marco402/piloteVMC/designSpark/README.md

# schéma  partie du projet PiloteVmc(// Développé par Marc Prieur (http://mesrealisations.000webhostapp.com/))

Les schémas sont développés sous DesignSpark pcb 8.1.
Je n'ai pas joint les pcb qui nécessiteront d'être repris en fonction des composants utilisés.

3 schémas sont présentés:
	-La partie traitement à base esp8266 et carte can bus.
	-La partie affichage à base arduino pro mini , carte can bus et afficheur st7735.
	-La partie relais pour boitier DIN.
	
	Le dossier user contient les composants ajoutés.
