marco402/piloteVMC/affichage/README.md

# Projet affichage partie du projet PiloteVmc(Développé par Marc Prieur https://marco40github.wixsite.com/website)

-Ce programme tourne sur un arduino mini pro.

-Il traite:
	-un poussoir sensitif pour changer de mode de fonctionnement(arrêt,vitesse lente,vitesse rapide...).
	-un afficheur ST7735.
	-le capteur humidité et température dht22 pour la cuisine.
	-le can bus liaison avec le boitier traitement.
	-un buzzer.
	-l'alimentation 5 volts est fournie par le boitier traitement par un câble de 4 fils bus can et alientation.
	-une prise à l'arrière du boitier permet de charger le programme par une liaison usb série.
