marco402/piloteVMC/traitement/README.md

------------------------------------------------------------------------------------------------------------------------

# Projet traitement partie du projet PiloteVmc(// Développé par Marc Prieur (https://marco40github.wixsite.com/website))

-Ce programme tourne sur un esp8266 0.9.

-Traitements:
 - Capteurs.
 - Liaison téléinformatique EDF.
 - CAN bus vers l'affichage réception des commandes.
 - Enregistrement.
 - Mise à l'heure
 - Commande de la VMC
