marco402/piloteVMC/TeleinfoVmc/README.md

Version initiale de TeleInfo
    version  https://github.com/BmdOnline/Teleinfo du 22/02/2017

Evolutions d'une version spécifique développée par Marc Prieur 07/2019.

Différences majeur avec la version initiale de TeleInfo:
    -La base de donnée est spécifique à l'application PiloteTempoVmc.
    -La librairie graphique est limitée à Highchart/HighStock.
    -Je n'ai pas repris/testé la version mobile.
    -J'ai intégré/testé que la version teleinfo mode historique.
    -J'ai ajouté la possiblité en cliquant sur la courbe d'enregistrer dans la base et d'afficher des annotations.
    -Ajout de 2 courbes spécifiques vmc et fonctionnel.

Pour davantage d'information, voir INSTALL.MD et https://mesrealisations.000webhostapp.com/.
