marco402/piloteVMC/sql/README.md

# Projet sql partie du projet PiloteVmc(// Développé par Marc Prieur (http://mesrealisations.000webhostapp.com/))

-Installer et paramétrer wamp server.

-Ouvrir phpmyadmin à partir de l'icone de wamp.

-Créer l'utilisateur (piloteVmc).
	-Privilèges --->ajouter nouvel utilisateur.
	-Mot de passe et privilèges...
	-Exécuter.

-Se positionner sur  le nouvel utilisateur .
	-Importer
	-Sélectionner le fichier du dossier sql.
	-Exécuter.

https://mesrealisations.000webhostapp.com/?p=569
