marco402/piloteVMC/todo.md

# Matériel
- Alimentation problème de reset notemment au déclenchement des radiateurs électriques(actuellement bloc externe simple).
- Revoir le capteur de courant entrée A0 hs, le capteur  au niveau du compteur doit capter trop de parasite destructeurs.
- Réglage luminositée de l'afficheur.
- Ajout d'une carte mini SD pour l'enregistrement limité actuellement à 1 jour avec un dt de 5mn.

# Logiciel
- Sur changement de mode simultané de auto vers arrêt avec un changement automatique marche arrêt simultané,
			la ventilation est passée en grande vitesse avec arrêt affiché.
