marco402/piloteVMC/designSpark/affichage_V2_st7735/affichage_v2.pdf

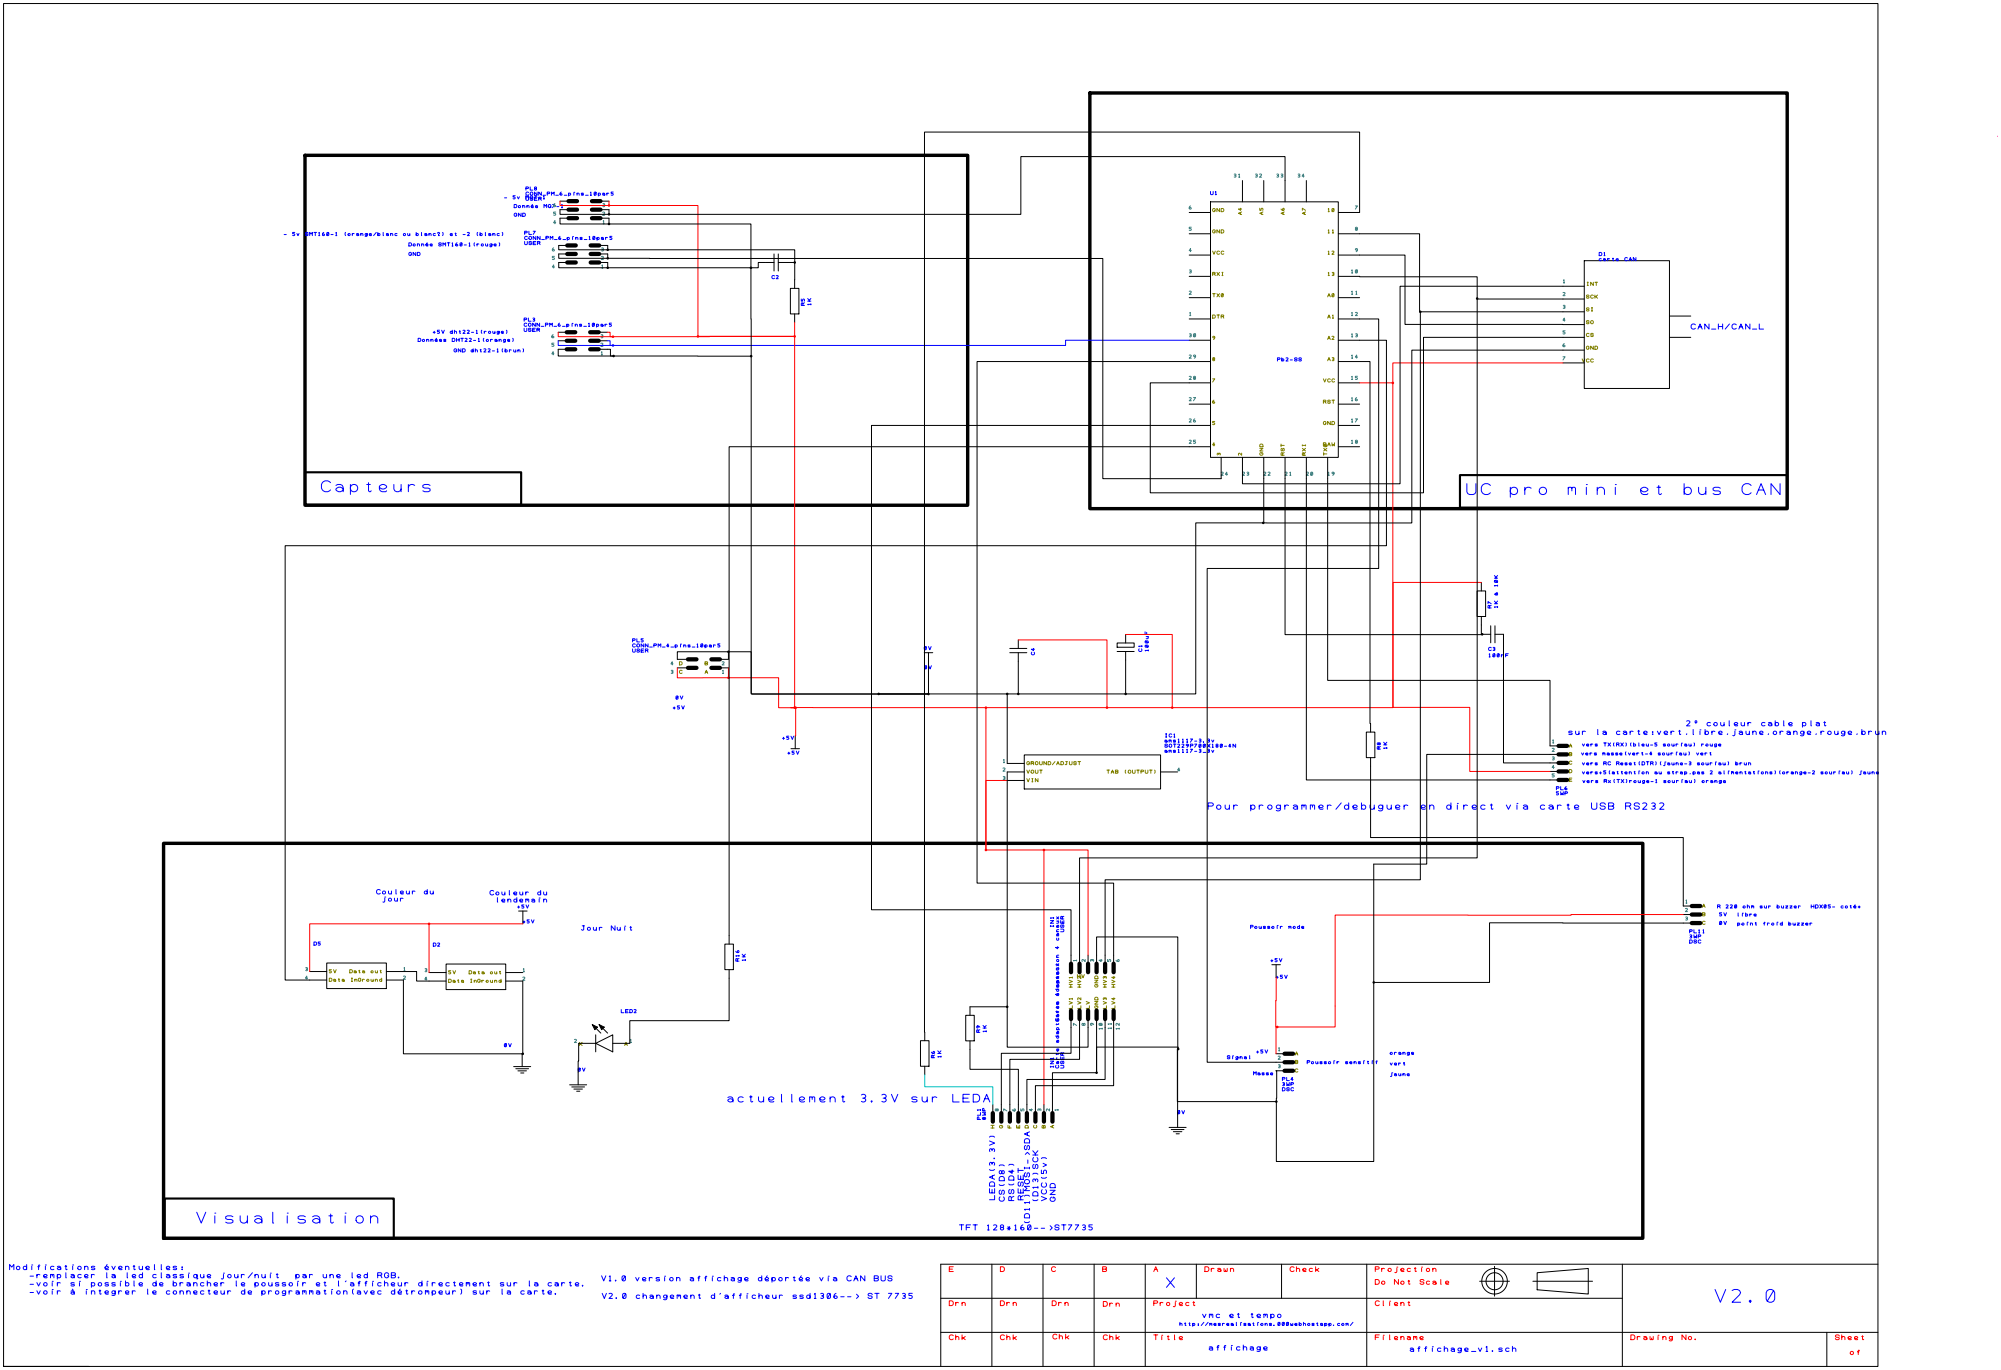
[picture p1: page 1]
