marco402/piloteVMC/designSpark/carte_relais_V2/relais.pdf

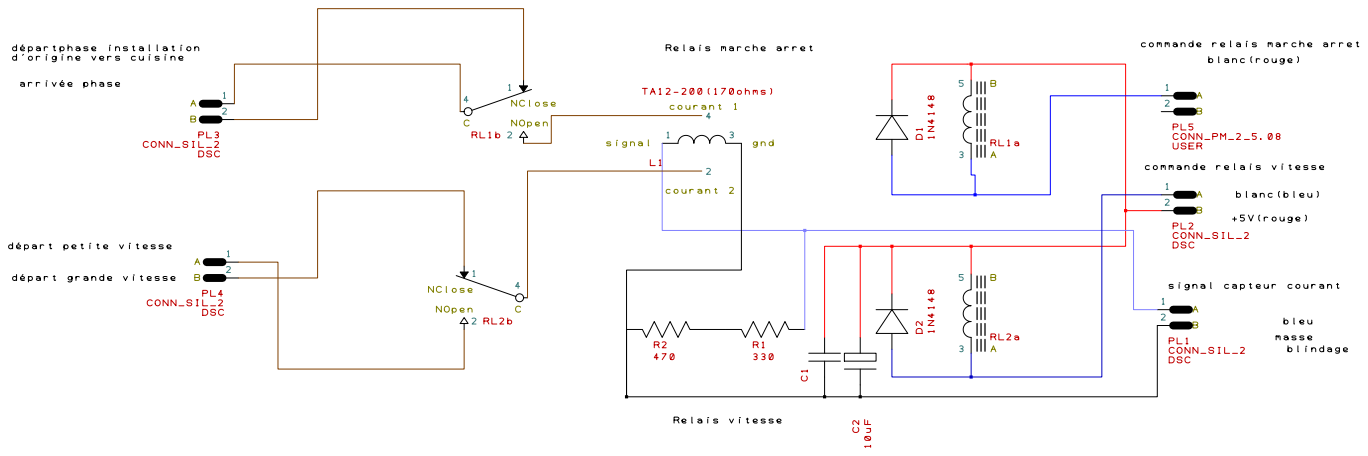
[picture p2: page 1]
