marco402/piloteVMC/designSpark/traitement/Traitement.pdf

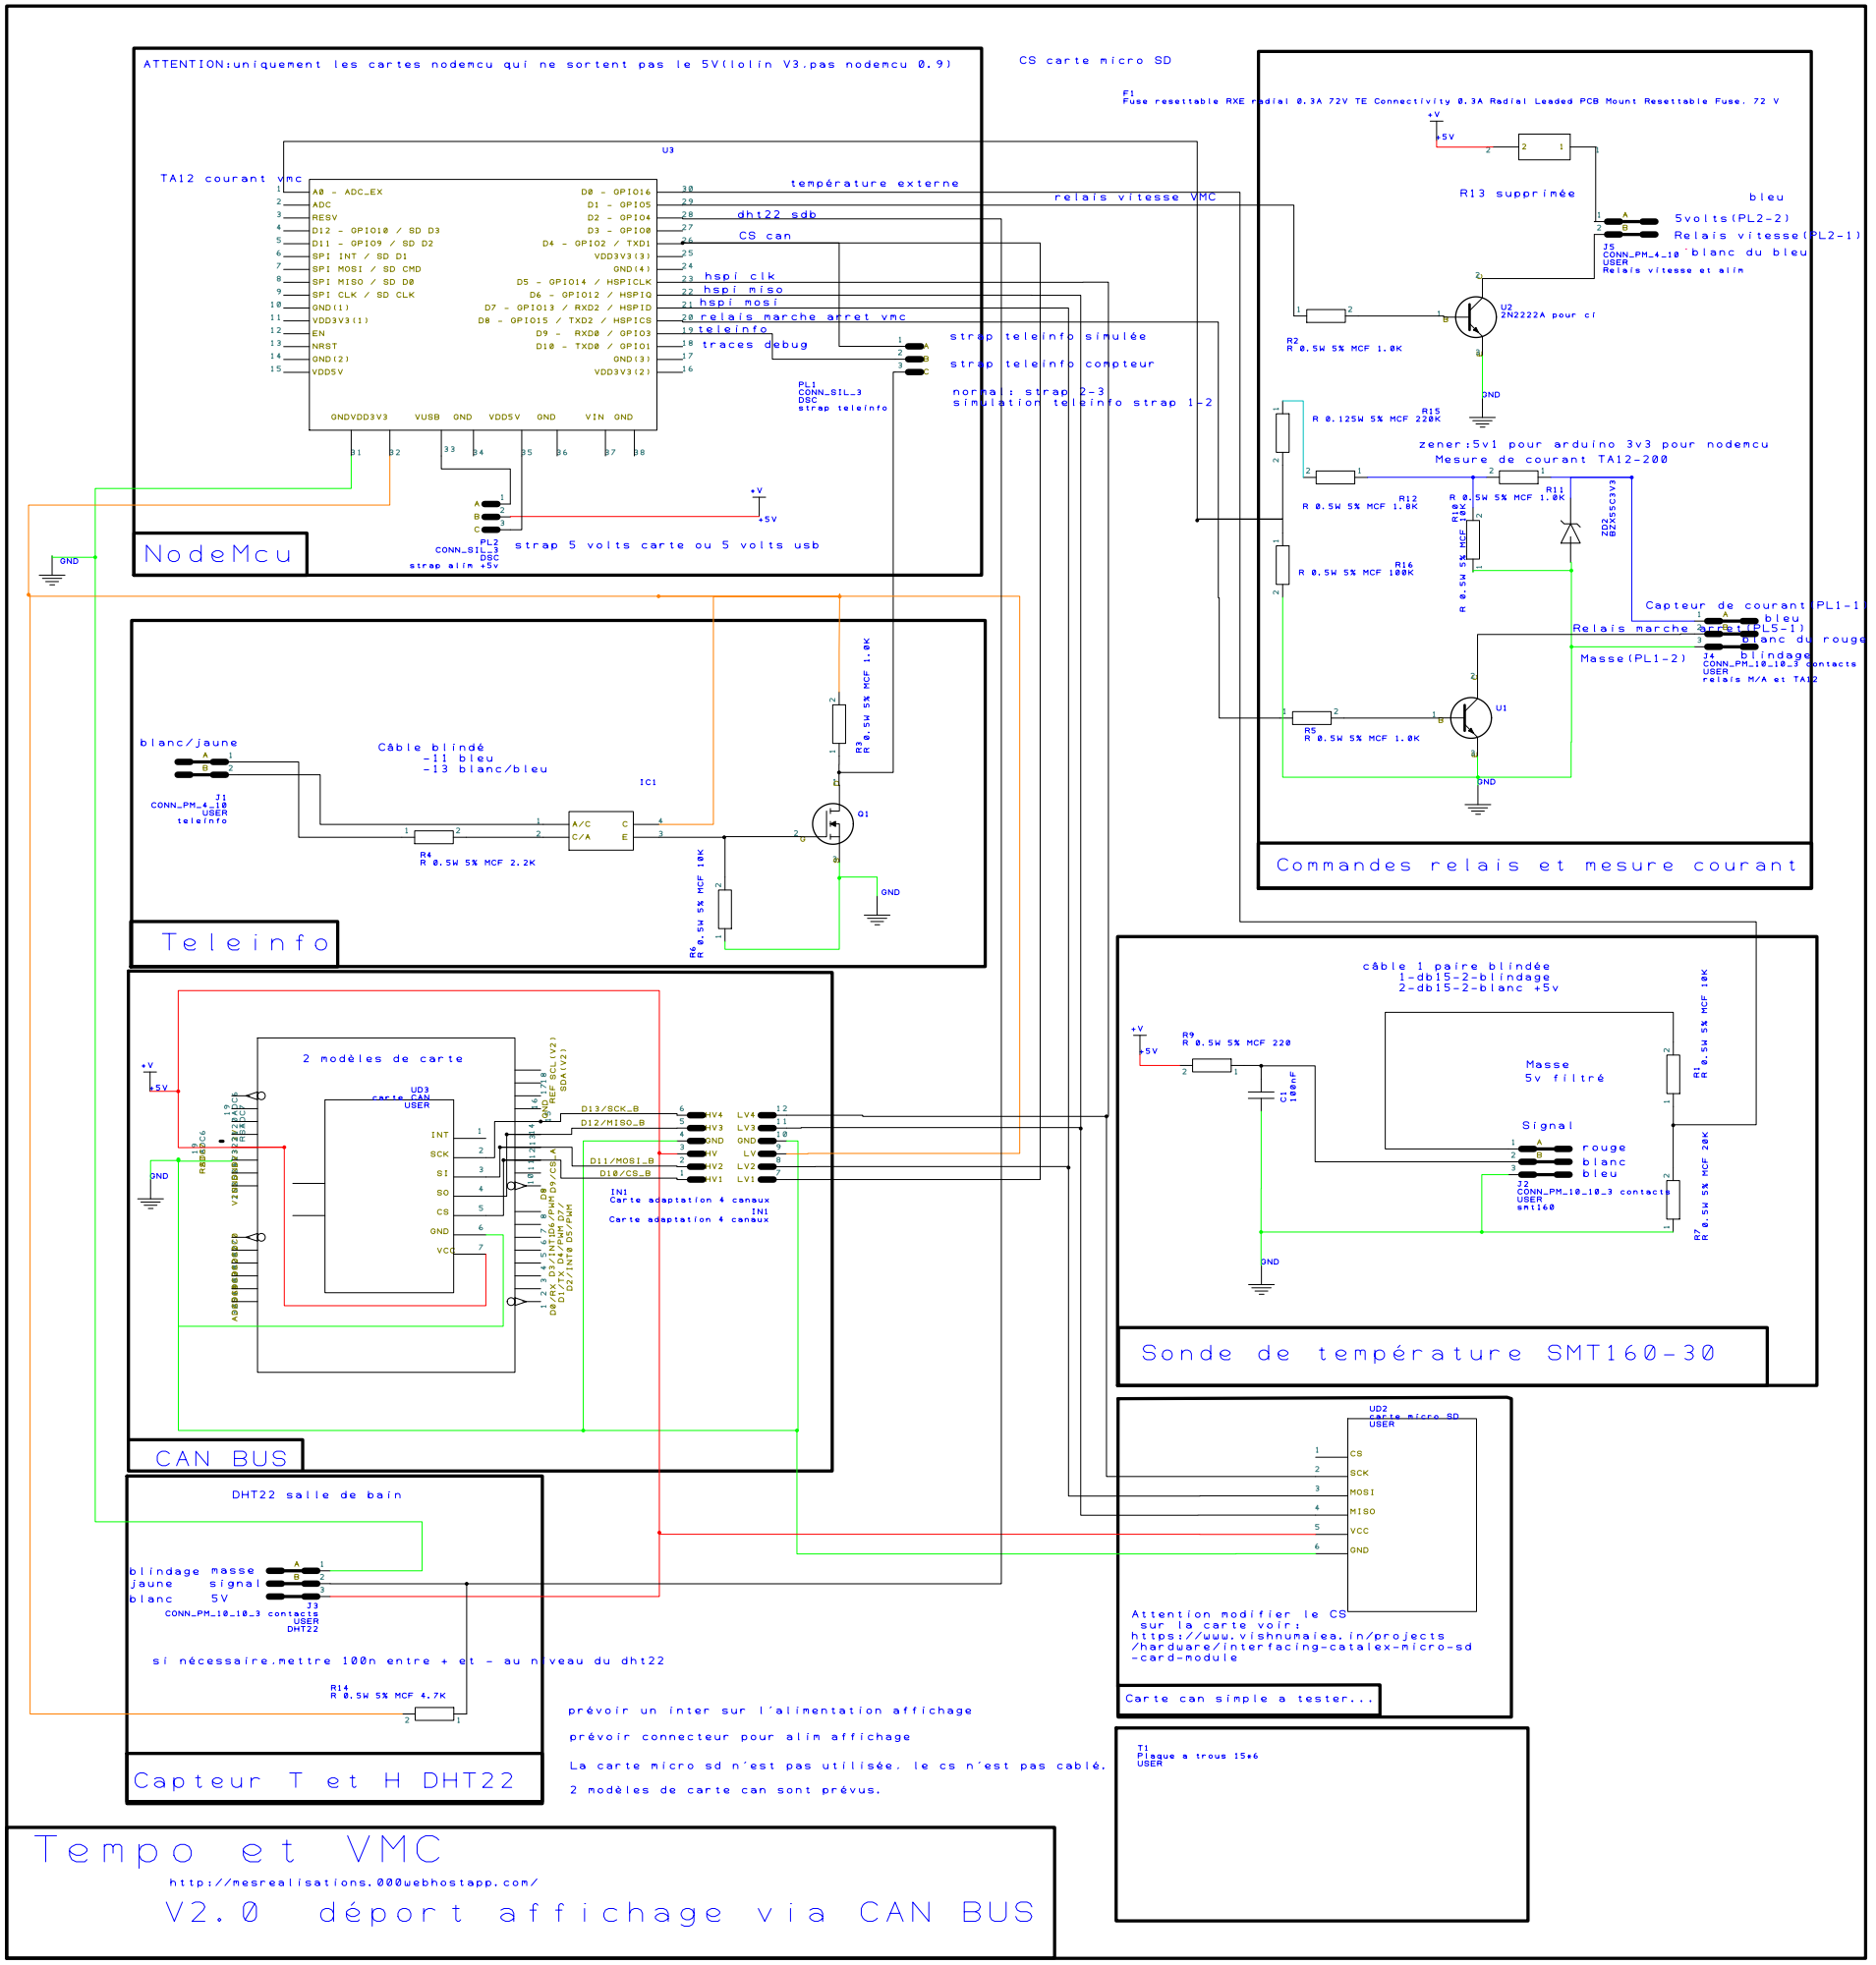
[picture p3: page 1]
