marco402/piloteVMC/LTspice/TA12 - 3.asc

C1: cap; 10n
D1: diode
D2: diode
R1: res; 100k
R2: res; 330k
R3: res; 800
V1: voltage; SINE(0 0.1 50); Rser=800
V2: voltage; 3.3
Named nets: 0, A0
.model BZX55C3V3 D(Is=1.5n Rs=.5 Cjo=185p nbv=3 bv=3.3 Ibv=1m Vpk=3.3 mfg=OnSemi type=Zener)
;ac lin 100 50 50
.tran 0.1
