marco402/piloteVMC/LTspice/TA12 - ok.asc

C1: cap; 10µ
R1: res; 150k
R2: res; 100k
R3: res; 800
R4: res; 220k
R5: res; 100k
V1: voltage; SINE(0 0.27 50); Rser=800
V2: voltage; 3.3
Named nets: 0, A0
.tran 0.1
https://openenergymonitor.org/forum-archive/node/156.html
