marco402/piloteVMC/LTspice/TA12.asc

D1: diode
D2: diode
DZ1: zener; BZX55C3V3
R1: res; 330
R2: res; 470
R3: res; 10000
R4: res; 220000
R5: res; 100000
R6: res; 1000
V1: voltage; SINE(0 0.270 50); Rser=800
Named nets: 0, A0
.model BZX55C3V3 D(Is=1.5n Rs=.5 Cjo=185p nbv=3 bv=3.3 Ibv=1m Vpk=3.3 mfg=OnSemi type=Zener)
;ac lin 100 50 50
.tran 0.1
