marco402/piloteVMC/traitement/vmc.cpp

// **********************************************************************************
// Programme traitement ESP8266 Pilotage VMC et TEMPO->Traitement de la VMC
// **********************************************************************************
// Creative Commons Attrib Share-Alike License
// You are free to use/extend this library but please abide with the CC-BY-SA license:
// Attribution-NonCommercial-ShareAlike 4.0 International License
// http://creativecommons.org/licenses/by-nc-sa/4.0/
//
// Written by Marc Prieur (https://marco40github.wixsite.com/website))
//
// History : V1.00 2018-03-23 - First release
//				   2021 ajout mode ETE HIVER
//
// All text above must be included in any redistribution.
//
// **********************************************************************************
//06/2022  supression des heures pour le mode été
//***********************************************************************************
#include <pgmspace.h>
#include <Arduino.h>
#include "Wifinfo.h"
#include "mySyslog.h"
#include "mySntp.h"
#include "constantes.h"
#include "dht.h"
#include "smt160.h"
#ifdef TA12
	#include "ta12.h"
#endif
#ifdef ALARME
#include "alarme.h"
#endif
#include "buzzer.h"
#include "config.h"
#include "interRelais.h"
#include "mySntp.h"
#include <WiFiUdp.h>  //pour enregistrement
#include "enregistrement.h"
#include "canBus.h"
#include "vmc.h"
#include "LibTeleinfo.h"
vmc::vmc()
{
}
void vmc::TRAITEMENTVMC(void)
{
	//***************************************Gestion de la mise en marche du relais de démarrage*************************************
	RELAIS.tempoChangementEtatRelais();
	//**************************************Traitement du mode VMC****************************************************
	//*****************Si le mode a changer, initialisation du nouveau mode
	//ATTENTION,le mode change ici mais le relais marche arret sera commandé 5 secondes plus tard-->en attendant:etatRelaisMarcheArret=ArretMarche::ARRET_REL;
	initialisationMode();
	lectureCapteurs();
	traitePeriodeVmc();
}

//void vmc::testTraitementVmc(void)
//{
////#ifndef TRAITMODE
//	if (traiteArretMarcheForce() == 0)
//	{
//			traitePeriodeVmc();
//	}
////#else
////			traitePeriodeVmc();
////#endif
//}

//appelé cycliquement sans condition par main_pilote_vmc.cpp
void vmc::setCptVmc(uint16_t T)
{
	cptSecondesVmcAuto = T;
}
void vmc::traiteRazCapteursAuto(void)
{
	if (cptSecondesVmcAuto >= (uint16_t)CONFIGURATION.config.tempo.periode_vmc_sec)  //déplacé ici sinon capteur de courant a 0
	{
		traiteMoyennePeriode();
		if (!(leMode == MODES::AUTO || leMode == MODES::ETE || leMode == MODES::HIVER))   //pour continuer a traiter les moyennes a la cadence vmc
			cptSecondesVmcAuto = 0;
	}
}
//void vmc::traiteEte()
//{
//	//DebugF("TEMPEXT: ");	Debugln((long)TEMPEXT.getMoyennePeriode());
//	//DebugF("DHTSDB.DHT_T: ");	Debugln((long)DHTSDB.DHT_T.getMoyennePeriode());
//	boolean entreAirFrais = (TEMPEXT.getMoyennePeriode() < (DHTSDB.DHT_T.getMoyennePeriode()));
//	//DebugF("entreAirFrais: ");	Debugln((long)entreAirFrais);
//	if (entreAirFrais)
//    {
//		RELAIS.traitementRelais(VITESSE_RELAIS::LENT_REL, ARRET_MARCHE::MARCHE_REL);
//    }
//	else
//    {
//		leMode = MODES::AUTO;
//		memoModes = MODES::AUTO;
//		decompteTempoArretMarcheForce = 0;
//		//RELAIS.traitementRelais(VITESSE_RELAIS::LENT_REL, ARRET_MARCHE::ARRET_REL);
//    }
//}
void vmc::traitementVMCHiver()
{
	//DebugF("TEMPEXT: ");	Debugln((long)TEMPEXT.getMoyennePeriode());
	//DebugF("TEMPSDB: ");	Debugln((long)DHTSDB.DHT_T.getMoyennePeriode());
//	if ((TEMPEXT.getMoyennePeriode() > (DHTSDB.DHT_T.getMoyennePeriode())))
	//if (RELAIS.getJour_Nuit())		//0:jour,3:nuit
	if(Clock.getHour() > 5 && Clock.getHour() < 23)
	{
		//DebugF("BIDON ");
		//forcageMode = MODES::BIDON;
		RELAIS.traitementRelais(VITESSE_RELAIS::LENT_REL, ARRET_MARCHE::ARRET_REL);
		//RELAIS.traitementRelais(VITESSE_RELAIS::LENT_REL, ARRET_MARCHE::MARCHE_REL);
	}
	else
	{
		traitementVMC();
		cptSecondesVmcAuto = 0;
		//DebugF("AUTO ");
		//forcageMode = MODES::AUTO;
		//leMode = MODES::AUTO;  //il faudrait indiquer a affichage->poussoir de forcer le mode auto
		//memoModes = MODES::AUTO;
//#ifndef TRAITMODE
		//decompteTempoArretMarcheForce = 0;
//#endif
	}
		//RELAIS.traitementRelais(VITESSE_RELAIS::LENT_REL, ARRET_MARCHE::ARRET_REL);
}

void vmc::traitePeriodeVmc()
{
	//if (traiteArretMarcheForce() > 0)
	//	return;
	if (cptSecondesVmcAuto >= (uint16_t)CONFIGURATION.config.tempo.periode_vmc_sec)
	{
		if (leMode == MODES::AUTO)
		{
			traitementVMC();
			cptSecondesVmcAuto = 0;
		}
		else if (leMode == MODES::ETE)
		{
			traitementVMCEte();
			cptSecondesVmcAuto = 0;
		}
		else if (leMode == MODES::HIVER)
		{
			traitementVMCHiver();
			cptSecondesVmcAuto = 0;
		}
		else
		{
			casAuto = 0;	//effacement du status auto
			info = CASSTATUS::ST_START;
#ifdef TA12
			TA12.traitementSeuilTa12();	//true si ok
#endif
		}
	}
	//if (leMode == MODES::ETE)
	//{
	//	traitementVMC();
	//	cptSecondesVmcAuto = 0;
	//	//traiteEte();
	//}
	//else 
	//if (leMode == MODES::HIVER)
	//{
	//	traitementVMCHiver();
	//	cptSecondesVmcAuto = 0;
	//}
}
void vmc::incrementeCptVmc()
{
	cptSecondesVmcAuto++;
}
//appel que si on a changé de mode Marche/arret, petite/grande vitesse ou automatique...
void vmc::initialisationMode()
{
	//DebugF("decompteTempoArretMarcheForce:"); Debugln(decompteTempoArretMarcheForce);
	//DebugF("tempoFinForcage:"); Debugln(tempoFinForcage);
	//noInterrupts();	//au cas ou: framework arduino ???
	if (memoModes != leMode)
	{
//#ifndef TRAITMODE
		memoRetourForcage = memoModes;
		decompteTempoArretMarcheForce = 0;				//sinon repart en auto en fin de tempo si on a pas fini le forçage
//#endif
		switch (leMode)
		{
		case MODES::ARRET:
			RELAIS.traitementRelais(VITESSE_RELAIS::LENT_REL, ARRET_MARCHE::ARRET_REL);
			ENREGISTREMENT.setCptSecPeriodeEnregistrement();		//pour les modes arret, les modes marche sont après la tempo sinon erreur sur marche/arret
      MYALARMEGARAGE.setRazAlarme();
       MYALARMEPORTAIL.setRazAlarme();
			break;
		case MODES::PETITE_VITESSE:
			RELAIS.traitementRelais(VITESSE_RELAIS::LENT_REL, ARRET_MARCHE::MARCHE_REL);
			break;
		case MODES::GRANDE_VITESSE:
			RELAIS.traitementRelais(VITESSE_RELAIS::RAPIDE_REL, ARRET_MARCHE::MARCHE_REL);
			break;
		case MODES::TEMPO_ARRET:
			RELAIS.traitementRelais(VITESSE_RELAIS::LENT_REL, ARRET_MARCHE::ARRET_REL);
			ENREGISTREMENT.setCptSecPeriodeEnregistrement();		//pour les modes arret
//#ifndef TRAITMODE
			//decompteTempoArretMarcheForce = CONFIGURATION.config.tempo.duree_forcage_sec;
//#endif
			break;
		case MODES::TEMPO_MARCHE_PV:
			RELAIS.traitementRelais(VITESSE_RELAIS::LENT_REL, ARRET_MARCHE::MARCHE_REL);
//#ifndef TRAITMODE
			//decompteTempoArretMarcheForce = CONFIGURATION.config.tempo.duree_forcage_sec;
//#endif
			break;
		case MODES::TEMPO_MARCHE_GV:
			RELAIS.traitementRelais(VITESSE_RELAIS::RAPIDE_REL, ARRET_MARCHE::MARCHE_REL);
//#ifndef TRAITMODE
			//decompteTempoArretMarcheForce = CONFIGURATION.config.tempo.duree_forcage_sec;
//#endif
			break;
		case MODES::AUTO:
//			modeEteEntreAirFrais = false;
			RELAIS.traitementRelais(VITESSE_RELAIS::LENT_REL, ARRET_MARCHE::ARRET_REL);
			ENREGISTREMENT.setCptSecPeriodeEnregistrement();		//pour les modes arret au depart
			break;
		case MODES::ETE:
//			modeEteEntreAirFrais = true;
			RELAIS.traitementRelais(VITESSE_RELAIS::LENT_REL, ARRET_MARCHE::ARRET_REL);
			ENREGISTREMENT.setCptSecPeriodeEnregistrement();		//pour les modes arret au depart
			//traiteEte();
			//RELAIS.traitementRelais(VITESSE_RELAIS::LENT_REL, ARRET_MARCHE::MARCHE_REL);
			break;
		case MODES::HIVER:
			traitementVMCHiver();
			//RELAIS.traitementRelais(VITESSE_RELAIS::LENT_REL, ARRET_MARCHE::MARCHE_REL);
			break;
		case MODES::BIDON:
			break;
		}
		setCptVmc(REINIT);	//annule l'attente pour le traitement vmc reste a cette valeur si pas en auto-->traitement a chaque cycle
		memoModes = leMode;
#ifdef TA12
		TA12.clrMoyennePeriodeCourante();
#endif
		//interrupts();
	}
	//if (tempoFinForcage > 0)
		//tempoFinForcage -= 1;
}

uint16_t  vmc::getDecompteTempoArretMarcheForce(void)const
{
	return decompteTempoArretMarcheForce;
}
//#ifndef TRAITMODE
//int vmc::traiteArretMarcheForce()
//{
//	if (decompteTempoArretMarcheForce == 0)
//	{
//		return 0;
//	}
//	else if (decompteTempoArretMarcheForce ==1 )		//on perd 2 sec sur la tempo...
//	{
//		leMode = memoRetourForcage;   //                                     MODES::AUTO;		//ne repasse pas en auto a voir
//		//memoModes= MODES::AUTO;
//		decompteTempoArretMarcheForce = 0;
//		//tempoFinForcage = 2;
//		//le mode repasse en AUTO et revient immédiatement en FORCE,
//        //probablement au niveau affichage emission d'un message force avant la prise
//        //en compte de la réception du message AUTO=>temporiser 5 sec.avant prise en comte d'un nouveau mode
//		DebuglnF("Fin forcage");   //------------------------>OK
//		return 1;
//	}
//	else
//	{
//		decompteTempoArretMarcheForce -= 1;
//		return 1;
//	}
//}
//#else
//uint16_t vmc::traiteArretMarcheForce(void)
//{
//	if (decompteTempoArretMarcheForce > 0)
//		decompteTempoArretMarcheForce -= 1;
//	return decompteTempoArretMarcheForce;
//}
//#endif
boolean vmc::traitementTempsMiniVMC(void)
{
	// ok Nbminute=HEURE.tm.Hour*60+HEURE.tm.Minute;
	// ok NbMinuteAvantMinuit=1440-LECTURESERIAL.tempsVmcMinParJour+getNbMinuteActiveJourCourant(); 
	//if ((HEURE.tm.Hour==23) && (HEURE.tm.Minute>=(60-(LECTURESERIAL.tempsVmcMinParJour-(NbSecondeActiveJourCourant/60)))))        //il est temps de ventiler jusqu'a minuit
	// OK if (((int)(HEURE.tm.Hour*60)+HEURE.tm.Minute)>=1425)    //(1440-((int)LECTURESERIAL.tempsVmcMinParJour-(NbSecondeActiveJourCourant/60))) && (leMode==AUTO)	)        //il est temps de ventiler jusqu'a minuit
	if (((Clock.getHour() * 60 + Clock.getMinute() ) > (1339 - CONFIGURATION.config.tempo.duree_mini_sec/60.0 + RELAIS.getNbMinuteActiveJourCourant())) && (leMode == AUTO))
	{
		RELAIS.traitementRelais(VITESSE_RELAIS::LENT_REL, ARRET_MARCHE::MARCHE_REL);   //toujours lent en mode auto ou force pour temps mini
		return true;
	}
	return false;
}
MODES vmc::getLeMode() const
{
	return leMode;
}
MODES vmc::getForcageMode()const
{
	return forcageMode;
}

String vmc::getLeModeString() const
{
	//return (char *)pgm_read_dword(&(MODES_AFF[leMode]));
	return FPSTR(MODES_AFF[leMode]);
}
void vmc::setLeMode(MODES lemode)
{
  //if (tempoFinForcage == 0)
	   leMode = lemode;
}
MODES vmc::getMemoModes() const
{
	return memoModes;
}
void vmc::traitementVMC(void)
{
	//-Le mode automatique permet de démarrer toujours en vitesse lente ou d'arrêter la vmc
	//	en fonction de critères prédéfinis et du paramétrage effectué a partir d'un pc.

	//	- 1 - Spécifique pour entrer de l'air frais l'été de Juin à Septembre inclus   :    //et de 22 à 8 heure inclus
	//Pour cette période, la vmc est en marche que si la température extérieur est inférieur à la température de la salle de bain
	//et la température de la salle de bain > 21
	//sinon toujours arrete pour ne pas entrer d'air chaud.

	//	- 2 - Spécifique pour entrer de l'air chaud l'hiver de Octobre à Mai inclus et de 9 à 21 heure inclus  :
	//Pour cette période, la vmc est en marche si la température extérieur est supérieur de 5 degrés à la température de la salle de bain.
	//	Si ces 2 cas n'ont pas démarré la vmc, 
	//	- 3 - Test de l'humidité cuisine puis
	//	- 4 - Test de l'humidité salle de bain
	//	Ces test de l'humidité ne peuvent se faire sur un seuil fixe parce que l'humidité intérieur est liée à l'humidité extérieur.
	//	Ces test ne tiennent donc pas compte de la valeur de l'humidité mais de sa variation.
	//	Si aucun de ces 4 tests démarre la vmc, celle - ci est arrêtée.


	//paramétrage via page web
		//seuil chaud(23)
		//seuil froid(25)
		//pourcent_hum(15)
		//période vmc(300)

	//initialisation
		//MoyennePourSeuil=70

	//fonctions appelées:
		//a la période vmc --->traiteMoyennePeriode(1)
			//dans traiteMoyennePeriode(1)---> traiteMoyennePourSeuil() si compteurCycleMoyennePourSeuil == NBCYCLESOK(10)

	//mode automatique
	//	uniquement  petite vitesse
		//cas été, limiter l'entrée d'air chaud et l'expulsion d'air plus frais-->évolution des seuils humidité	SeuilHC et SeuilHB
	//cas traités dans l'ordre:
		//1-cas hiver, limiter l'entrée d'air froid  et l'expulsion d'air chaud			température ext > seuil chaud------------>arret
				//en modifiant les seuils humidité proportionellement à température cuisine - température extérieur
		//2-cas humidité cuisine trop élevé par rapport à un seuil évolutif	SeuilHC---------------------------------------------->marche
		//3-cas humidité salle de bain trop élevé par rapport à un seuil évolutif SeuilHB---------------------------------------->marche
		//4-sinon---------------------------------------------------------------------------------------------------------------->arret

//	Pour l'humidité, le principe de seuil fixe ne fonctionne pas, il faut adapter le seuil en fonction de "l'humiditée générale"

	//traitement des seuil SeuilHC et SeuilHB
		//si la température intérieure <= seuil froid
			//Seuil=humiditée moyenne pour seuil+(température moyenne-température extérieur)/pourcent_hum

	//traitement de humiditée moyenne pour seuil
		//si la température moyenne est > température pour seuil 10 cycles vmc consécutif, le pourcentageSeuil(différent de pourcent_hum)=+1
		//si la température moyenne est < température pour seuil 10 cycles vmc consécutif, le pourcentageSeuil =-1
		
		//dans ces 2 cas, on recalcul la moyenne pour seuil = moyennePourSeuil + (moyennePourSeuil * pourcentageSeuil) / 100;

		//le pourcentageSeuil seuil évolue donc au minimum tous les 300 * 10 secondes


		//DebugF("DHTCUISINE_T.getMoyennePeriode: "); Debugln(DHTCUISINE_T.getMoyennePeriode());

	SeuilHC = DHTCUISINE_H.getMoyennePourSeuil();
	SeuilHB = DHTSDB.DHT_H.getMoyennePourSeuil();
		////DebugF("SeuilHCav: "); Debugln(SeuilHC);
		////DebugF("SeuilHBav: "); Debugln(SeuilHB);

		////if ((DHTCUISINE_T.getMoyennePeriode()<= CONFIGURATION.config.tempo.seuil_temp_froid_dixieme_degres) && (CONFIGURATION.config.tempo.pourcent_hum > 0))  //c'est l'hiver:moins d'air frais si...
		////	SeuilHC += (DHTCUISINE_T.getMoyennePeriode() - TEMPEXT.getMoyennePeriode()) / (CONFIGURATION.config.tempo.pourcent_hum*10);//*10 temperature en dixieme
		////if ((DHTSDB.DHT_T.getMoyennePeriode() <= CONFIGURATION.config.tempo.seuil_temp_froid_dixieme_degres) && (CONFIGURATION.config.tempo.pourcent_hum > 0))  //c'est l'hiver:moins d'air frais si...
		////	SeuilHB += (DHTSDB.DHT_T.getMoyennePeriode() - TEMPEXT.getMoyennePeriode()) / (CONFIGURATION.config.tempo.pourcent_hum*10);//*10 temperature en dixieme
		///*	DebugF("SeuilHC: "); Debugln(SeuilHC);
		//	DebugF("SeuilHB: "); Debugln(SeuilHB);*/
		//DebugF("TEMPEXT.getMoyennePeriode(): "); Debugln(TEMPEXT.getMoyennePeriode());
		//DebugF("DHTCUISINE_H.getMoyennePeriode(): "); Debugln(DHTCUISINE_H.getMoyennePeriode());
		//DebugF("DHTSDB.DHT_H.getMoyennePeriode(): "); Debugln(DHTSDB.DHT_H.getMoyennePeriode());
		//DebugF("seuil_temp_chaud_dixieme_degres: "); Debugln(CONFIGURATION.config.tempo.seuil_temp_chaud_dixieme_degres);
		//DebugF("seuil_temp_froid_dixieme_degres: "); Debugln(CONFIGURATION.config.tempo.seuil_temp_froid_dixieme_degres);
		//boolean tropFroidDehors = (TEMPEXT.getMoyennePeriode() < CONFIGURATION.config.tempo.seuil_temp_froid_dixieme_degres);//c'est l'hiver trop froid dehors risque de ne plus ventiler

	//lecture couleur du jour
	//char  valeurs[LONGMAXMOT];
	//
	//memset(valeurs, 0, sizeof(valeurs));
	//TINFO.valueGet(&TableauTempoName[TEMPO_UTILISE::ETU_PTEC][0], &valeurs[0]);
	//if (((valeurs != NULL) && (valeurs[0] != '\0')))
	//{
	//	CouleurEnCours = atoi(valeurs);
	//}
	


	//DebugF("entreAirFrais: ");	Debugln((long)entreAirFrais);
	//if (entreAirFrais)
	//{
	//	RELAIS.traitementRelais(VITESSE_RELAIS::LENT_REL, ARRET_MARCHE::MARCHE_REL);
	//}



	//0:bleu nuit,1:blanc nuit,2:rouge nuit,3:bleu jour,4:blanc jour,5:rouge jour
	   	//boolean tropChaudDehors = (TEMPEXT.getMoyennePeriode() > CONFIGURATION.config.tempo.seuil_temp_chaud_dixieme_degres);

		//commenté 07/2021 d'ou ça sort??
		//if (CouleurEnCours == COULEURJOUR::ROUGE_JOUR)
		//{
		//	RELAIS.traitementRelais(VITESSE_RELAIS::LENT_REL, ARRET_MARCHE::ARRET_REL);   
		//	casAuto = CASSTATUS::ST_ROUGEJOUR; //affichage du nombre de minute restante
		//	seuilAuto = 0;
		//}
		//else 
		//if (tropChaudDehors)
		//{
		//	RELAIS.traitementRelais(VITESSE_RELAIS::LENT_REL, ARRET_MARCHE::ARRET_REL );							//c'est l'été trop chaud dehors seuil de temperature qui permet de ventiler la nuit.
		//	casAuto = CASSTATUS::ST_TROPCHAUD;
		//	seuilAuto = CONFIGURATION.config.tempo.seuil_temp_chaud_dixieme_degres/10;
		//	//DebuglnF("2");
		//}
		cuisineTropHumide = (DHTCUISINE_H.getMoyennePeriode() > SeuilHC);
		salledebainTropHumide = (DHTSDB.DHT_H.getMoyennePeriode() > SeuilHB);
		//entreAirFraisEte = ((TEMPEXT.getMoyennePeriode() < (DHTSDB.DHT_T.getMoyennePeriode())) && (DHTSDB.DHT_T.getMoyennePeriode() > 210) );
		//entreAirFraisEte = TEMPEXT.getMoyennePeriode() < DHTSDB.DHT_T.getMoyennePeriode();
		//entreAirChaudHiver = (TEMPEXT.getMoyennePeriode() > (DHTSDB.DHT_T.getMoyennePeriode() + 50));  //50-->5°
		//heureOKentreAirFrais =(Clock.getHour() < 8) || ( Clock.getHour() > 22);
		//moisOKentreAirFrais =(Clock.getMonth() > 05) && (Clock.getMonth() < 10) ;
		/*if (entreAirFraisEte && (DHTSDB.DHT_T.getMoyennePeriode() > 210) && heureOKentreAirFrais)
	    {
			RELAIS.traitementRelais(VITESSE_RELAIS::LENT_REL, ARRET_MARCHE::MARCHE_REL);
	    }
		else if (!entreAirFraisEte && heureOKentreAirFrais)
		{
			RELAIS.traitementRelais(VITESSE_RELAIS::LENT_REL, ARRET_MARCHE::ARRET_REL);
		}*/
		//else if (entreAirChaudHiver && !heureOKentreAirFrais && !modeEteEntreAirFrais)
	 //   {
		//	RELAIS.traitementRelais(VITESSE_RELAIS::LENT_REL, ARRET_MARCHE::MARCHE_REL);
	 //   }
		if (salledebainTropHumide)
		{
			RELAIS.traitementRelais(VITESSE_RELAIS::LENT_REL, ARRET_MARCHE::MARCHE_REL);						//trop d'humidité cuisine
			casAuto = CASSTATUS::ST_SDBTROPHUM;
			seuilAuto = SeuilHB;
			DebuglnF("auto 1");
		}	
		else if (cuisineTropHumide)
			{
			RELAIS.traitementRelais(VITESSE_RELAIS::LENT_REL, ARRET_MARCHE::MARCHE_REL);						//trop d'humidité salle de bain
			casAuto = CASSTATUS::ST_CUISTROPHUM;
			seuilAuto = SeuilHC;
			DebuglnF("auto 2");
			}
		else //if (RELAIS.getEtatReelRelaisMarcheArret()== ARRET_MARCHE::MARCHE_REL)
			{
			RELAIS.traitementRelais(VITESSE_RELAIS::LENT_REL, ARRET_MARCHE::ARRET_REL);   						//arret si aucun cas demande de ventiler
			casAuto = CASSTATUS::ST_START; //affichage du nombre de minute restante
			seuilAuto= 0;
			DebuglnF("auto 3");
			}
		//DebugF("casAuto: "); Debugln(casAuto);
		//DebugF("seuilAuto: "); Debugln(seuilAuto);
}
void vmc::traitementVMCEte(void)
{
	entreAirFraisEte = TEMPEXT.getMoyennePeriode() < DHTSDB.DHT_T.getMoyennePeriode();
	heureOKentreAirFrais = (Clock.getHour() < 9) || (Clock.getHour() > 20);
	if (entreAirFraisEte && heureOKentreAirFrais)
	{
		RELAIS.traitementRelais(VITESSE_RELAIS::LENT_REL, ARRET_MARCHE::MARCHE_REL);
		DebuglnF("ete 1");
	}
	else if (!entreAirFraisEte && heureOKentreAirFrais)
	{
		RELAIS.traitementRelais(VITESSE_RELAIS::LENT_REL, ARRET_MARCHE::ARRET_REL);
		DebuglnF("ete 2");
	}
	else 
	{
		RELAIS.traitementRelais(VITESSE_RELAIS::LENT_REL, ARRET_MARCHE::ARRET_REL); 
		casAuto = CASSTATUS::ST_START; //affichage du nombre de minute restante
		seuilAuto = 0;
		DebuglnF("ete 3");
	}
}

//appelé quand cptSecondesVmcAuto>=LECTURESERIAL.periode_vmc
void vmc::traiteMoyennePeriode(void)
{
		DHTSDB.DHT_T.traiteMoyennePeriode(false);
		DHTSDB.DHT_H.traiteMoyennePeriode(true);
#ifdef DEBUGDHT
		DebugF("vmc:mps"); Debugln((uint8_t)DHTSDB.DHT_H.getMoyennePourSeuil());
		DebugF("vmc_%s:"); Debugln(DHTSDB.DHT_H.getPourcentageSeuil());
#endif
		DHTCUISINE_T.traiteMoyennePeriode(false);  //capteurs distants
		DHTCUISINE_H.traiteMoyennePeriode(true);  //capteurs distants
		TEMPEXT.traiteMoyennePeriode(false);
#ifdef TA12
		TA12.traiteMoyennePeriode(false);
#endif
		//DebugF("1 TA12.getMoyennePeriode: "); Debugln(TA12.getMoyennePeriode());
		//DebugF("1 TA12.getPuissanceConsommee: "); Debugln(TA12.getPuissanceConsommee());
}
void vmc::lectureCapteurs(void)
{
	DHTSDB.lectureCapteur();
	TEMPEXT.lectureCapteur();
 #ifdef PIN_CS_CAN
	if (CAN_BUS.getReceptionCapteurs())
	{
	DHTCUISINE_T.traiteMesure(CAN_BUS.getTCuis());
	DHTCUISINE_H.traiteMesure(CAN_BUS.getHCuis());
	CAN_BUS.resetReceptionCapteurs();
	}
 #endif
}
uint8_t vmc::getSeuilAuto(void) const
{
	return seuilAuto;
}
uint8_t vmc::getCasAuto(void) const
{
	return casAuto;
}
uint16_t  vmc::getSeuilHC(void)const
{
	return SeuilHC;
}
uint16_t  vmc::getSeuilHB(void)const
{
	return SeuilHB;
}
