marco402/piloteVMC/traitement/modele_configWifi.h

//fichier de config perso,personellement je l'ai mis sur ./ ,surtout util en phase de développement.
#ifndef __CONFIGWIFI_H__
#define __CONFIGWIFI_H__
	#define CFG_DEF_SSID  ("votre ssid")
	#define CFG_DEF_PSK  ("votre psk")
	#define CFG_EMON_DEFAULT_APIKEY  ("votre emon key si necessaire")
	#define DEFAULT_OTA_AUTH     ("votre cle ota")
#endif
