marco402/piloteVMC/traitement/simuTempo.cpp

// **********************************************************************************
// Programme traitement ESP8266 Pilotage VMC et TEMPO->Simulation de messages tempo version historique
// **********************************************************************************
// Creative Commons Attrib Share-Alike License
// You are free to use/extend this library but please abide with the CC-BY-SA license:
// Attribution-NonCommercial-ShareAlike 4.0 International License
// http://creativecommons.org/licenses/by-nc-sa/4.0/
//
// Written by Marc Prieur (https://marco40github.wixsite.com/website))
//
// History : V1.00 2018-03-23 - First release
//
//
// All text above must be included in any redistribution.
//
// **********************************************************************************
#include <Arduino.h>
#include "Wifinfo.h"
#include "mySyslog.h"
#include "LibTeleinfo.h"
#include "constantes.h"
#include "simuTempo.h"
#define NO_DEBUGSIMU
//OK FIXE:HHPHC,IINST,MOTDETAT,IMAX
//OK EVOL:PTEC,DEMAIN,
//1 seul compteur 1 fois BBRHPJR e 0
//pb OPTARIF:0000013081SOUSC
//manque 5 compteurs,ADCO,ISOUSC dans OPTARIF
//plantage au load esp8266 si tableaux dans la classe
//char TRAME[][NBCHAR] = { "\x02\0","\rADCO 039801172264 \0", "\rOPTARIF BBR* \0", "\rISOUSC 45 \0",
//"\rBBRHCJB 000000000 \0", "\rBBRHPJB 000000000 \0", "\rBBRHCJW 000000000 \0",
//"\rBBRHPJW000000000 \0", "\rBBRHCJR 000000000 \0", "\rBBRHPJR 000000000 \0",
//"\rPTEC HCJB \0",	"\rDEMAIN BLEU \0",	"\rIINST 001 \0","\rIMAX 025 \0",
//"\rHHPHC Y \0","\rMOTDETAT 000000 \0","\x03\0" };
#ifdef MODE_HISTORIQUE
  char TRAME[][NBCHAR] = { "\x02\0",
  "\nBBRHCJB 000000000 \0", "\nBBRHCJW 000000000 \0", "\nBBRHCJR 000000000 \0",
  "\nBBRHPJB 000000000 \0", "\nBBRHPJW 000000000 \0", "\nBBRHPJR 000000000 \0",
  "\nADCO 039801172264 \0", "\nOPTARIF BBR* \0", "\nISOUSC 45 \0",
  "\nPTEC HCJB \0",	"\nDEMAIN BLEU \0",	"\nIINST 001 \0","\nIMAX 025 \0",
  "\nHHPHC Y \0","\nMOTDETAT 000000 \0","\x03\0" };
   char Etiq[][13] = { "STX", "BBRHCJB","BBRHCJW","BBRHCJR","BBRHPJB","BBRHPJW","BBRHPJR", "ADCO", "OPTARIF",
   "ISOUSC", "PTEC", "DEMAIN", "IINST", "IMAX", "HHPHC", "MOTDETAT" };
  // _separator = 0x20;
#else
	//_separator =2*TINFO_HT;
//champs evolutifs
	//EASF01(9) a EASF06   6 compteurs remplace BBRHxx  9 char
	//NJOURF(2) remplace PTEC
	//NJOURF+1(2) remplace DEMAIN	
	//IRMS1(3) remplace IINST
	//RELAIS(3) remplace MOTDETAT a voir
//champs constants
	//LTARF(16) tarif remplace OPTARIF
	//ADSC(12) remplace ADCO
	//ajout:
	//SMAXSN(5) horodatee

	//enleve:
	//"\rISOUSC 45 \0",
	// "\rIRMS1 001 \0"
	//"\rIMAX 025 \0",
	//"\rHHPHC Y \0",E200927185432
  char TRAME[][NBCHAR] = { "\x02\0",
  "\nEASF01\t000000001\t\0", "\nEASF02\t000000002\t\0", "\nEASF03\t000000003\t\0",
  "\nEASF04\t000000004\0", "\nEASF05\t000000005\t\0", "\nEASF06\t000000006\t\0",
  "\nADSC\t000123456789\t\0", "\nLTARTF\tBBR)\t\0", 
  "\nNJOURF\t01\t\0","\nNJOURF+1\t02\t\0",
  "\nIRMS1\t010\t\0",  "\nRELAIS\t011\t\0","\nSMAXSN\t12345\tE200927185432\t\0","\x03\0" };  //,"\nDATE\tE200927185432\t\0"
  char Etiq[][13] = {  "ADSC", "VTIC", "DATE", "NGTF", "LTARF", "EAST","EASF01","EASF02","EASF03","EASF04",  //10
  "EASF05","EASF06", "EASF07", "EASF08", "EASF09", "EASF10", "EASD01", "EASD02", "EASD03", "EASD04",  //10
  "EAIT", "ERQ1", "ERQ2", "ERQ3", "ERQ4", "IRMS1", "IRMS2", "IRMS3", "URMS1", "URMS2",  //10
  "URMS3","PREF","PCOUP", "SINSTS","SINSTS1","SINSTS2","SINSTS3","SMAXSN","SMAXSN1","SMAXSN2",  //10
  "SMAXSN3","SMAXSN-1","SMAXSN1-1","SMAXSN2-1","SMAXSN3-1","SINSTI","SMAXIN","SMAXIN-1","CCASN","CCASN-1",  //10
  "CCAIN","CCAIN-1","UMOY1","UMOY2","UMOY3","STGE","DPM1","FPM1","DPM2","FPM2", //10
  "DPM3","FPM3","MSG1","MSG2","PRM","RELAIS","NTARF","NJOURF","NJOURF+1","PPOINTE"};
#endif
 char tableauPtecSimu[][5] = { "STX", "HCJB", "HCJW", "HCJR", "HPJB", "HPJW", "HPJR" };
 char tableauDemain[][5] = { "BLEU", "BLAN", "ROUG" };
unsigned int compteur[7] = { 0,0,0,0,0,0,0 };
#define NO_X86   //pour x86


//options supplementaire du compilateur, ajouter -fpermissive 
//ATTENTION a tabnames de webserver.cpp si version LibTeleinfo-syslog.zip
//avec esp12 0.9
//strapper ces 2 pins:
//emission sur serial1 esp12-->GPIO2--->TXD1-->D4
//reception sur serial apres le swap-->GPIO13---->RXD2--->D7
//fonctions calcChecksum de LibTeleinfo modifie
unsigned char SimuTempo::calcChecksum(char *mot)
{
//mode standard revoir si utilisation horodate
	unsigned int  sum = _separator;  // Somme des codes ASCII du message + un espace
							  // avoid dead loop, always check all is fine 
	if (mot) {
		// this will not hurt and may save our life ;-)
		if (strlen(mot)) {
			while (*mot)
				sum += *mot++;
			return ((sum & 0x3f) + 0x20);
		}
	}
	return 0;
}
/* ======================================================================
Function: initSimuTrame
Purpose :
Input   :
Output  : -
Comments: -
====================================================================== */
int SimuTempo::randMinMax(int min, int max)
{
	return rand() % (max - min + 1) + min;
}
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
