marco402/piloteVMC/(commit log)

2019-08-25 projet MessagePiloteVersSql
    Les connexions de test restaient ouvertes.
2019-09-08 Traitement reconnect after sleep version de test.
    Lorsque l'ESP veux se reconnecter après un sleep(MODEM_SLEEP_T) programmé
    par l'utilisateur et que la wifi sur la box est coupée,
    l'ESP essai de se reconnecter toutes les secondes
    ce qui empeche le programme de fonctionner.
    symptome:ATT BUS CAN sur le module affichage.
    Le problème n'est pas réglé dans cette version.
2019-09-12 Traitement:supression du passage en MODEM_SLEEP_T
    le retour en mode normal alors que la box est coupée par la désactivation horaire
    monopolise le temps uc.
2019-09-14 Traitement,affichage,teleinfoVmc,messagePiloteVmcVersSql
    Traitement:supression de la coupure wifi programmée, le retour alors que
    la box wifi est désactivée dans une plage horaire prend trop de temps.
    Affichage:modification pour gérer le débordement millis() à 51 jours.
    teleinfoVmc:commentaires.
    messagePiloteVmcVersSql:correction sur le compteur, il y avait un enregistrement
    de décalage.
    [ClassMySql.cpp, affichage.ino, poussoir.cpp, ta12.cpp, webclient.cpp]
2019-09-18 messagePiloteVmcVersSql:Correction du traitement des compteurs suite à le modification précédente.
    [ClassMySql.cpp, enregistrement.cpp]
2019-11-10 Erreur sur changement d'heure et pb TA12.
    Correctif library SNTPClock erreur sur changement d'heure.
    Reprise TA12 en cours, l'entrée A0 semble HS.
    [Traitement.sch]
2021-04-28 mise à jour lien site
    [affichage_v2.sch]
2021-07-11 version sans visual micro fin de licence
    version a terminer
    [Traitement.sch]
2021-12-21 ajout mode ete mode hiver
    pb fin de mode forcé ??
    reste a voir:
    affichage:
    -luminositee ecran
    -remplacer led jour nuit par led rgb
    -mesurer consommation alimentation
    traitement
    -mesurer consommation alimentation
    -revoir mesure de courant vmc,
    je pense que l'entree A0 est cramée due a la
    commutation des relais de puissance cumulus et chauffage
    -revoir l'alimentation.
    [Traitement.sch]
2022-03-23 passage a arduino 1.8.19 et nodemcu 2.5.2
    avec nodemcu 3.0.2 probleme spiffs a voir
    [SNTPTime.cpp, SNTPTime.h, affichage.ino, canBus.cpp, constantes.h, ledsRGBSerial.cpp, mySyslog.cpp, traitement.ino]
2022-03-23 désactive le bus can ou le wifinfo par options de compilation(a essayer)
2022-06-27 -traitement: passage du systeme de fichier de SPIFFS a littleFS(changement de version version esp8266 3.0.2 et arduino:1.8.19) -prise en compte du port s'il est change en fonctionnement -dans traitem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
    [Traitement.sch]
2022-07-15 traitement heure suite a coupure avec wifi off
    [Traitement.sch]
2022-10-03 version livree traitement sans alarme
    sauvegarde .bin dans C:\marc\developpement\vmc et tempo bus can\version livrees
    reste a tester les commandes temporiser, il faut livrer affichage.
    [affichage_v2.sch]
2022-10-07 version affichage et traitement installees
    avec TRAITMODE sur les 2 projets
    avec HORLOGE sur affichage
    sans ALARME sur les 2 projets
    problème sur petite vitesse forcee decompte ok mais ne s'arrete pas.
    voir derniere ligne affichage libre
2022-10-09 affichage sans TRAITMODE
    garder le message CAN pour traitement
    revoir les commandes temporisees
2022-11-07 Traitement et affichage livres
    ajout HORLOGE sur affichage
    ajout ALARME mais desactive probleme de memoire
    [ClassMySql.cpp, SNTPTime.cpp, Wifinfo.h, affichage.ino, alarme.cpp, alarme.h, buzzer.cpp, buzzer.h]
2022-11-09 memoire alarme commandes temporisees
    memoire affichage ajout de F()
    mise en place alarme
    correction commandes temporisees traitement dans affichage
    [affichage.ino, canBus.cpp, constantes.h, constantesPartagees.h, dht.cpp, ledsRGBSerial.cpp, poussoir.cpp, poussoir.h]
2022-11-15 ajustage des couleurs et reinit canBus
2022-12-15 Traitement modification mode hiver pour cheminee allumee Affichage reinitialisation can bus si le temps n'evolue pas 10 cycles teleinfoVmc modifie affichage historique
    Traitement:
    pb avec le mode standard pour le linky, a revoir
    l'option de compilation MODE_HISTORIQUE dans constantes.h ne
    fonctionne pas???
    webserveur commenté le passage de watt en kilowatt a revoir
    [Traitement.sch]
2023-08-11 essai de reprise erreur reception can cote traitement a valider
    modif heure d'ete hiver, reste un pb...
    [Traitement.sch]
2023-10-18 livraison 18/10/23 debug can bus cote traitement
2023-11-30 version en phase avec alarme,traitement et affichage
    reste a ajuster la duree heartbeat
    ajouter test dans traitement si pas de portail ou garage
    if (adresseIP[0]>0)
    {...
2024-03-16 affichage déplacement de la relance chien de garde
2024-04-23 affichage:ajout heure changement de compteur ajout test watchDog(led jour/nuit)
2025-06-28 version livre au passage ADSL vers Fibre
    [Traitement.sch]
2025-10-21 affichage supression test limitation luminositée leds
    [Traitement.sch, relais.sch]
2025-11-30 affichage -supression du bip -supression watchdog remplacé par un restart si 20 secondes sans reception CanBus traitement -voir enregistrement UNMES -syslog voir manque process_line messagepilotevers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
    [Traitement.sch]
2026-02-02 essai ajout sleep pour redonner la main a esp8266 sinon reboot pendant la reception watch dog
    [ClassReceptionUdp.cpp, traitement.ino]
