marco402/piloteVMC/(notices)

Notices in the files:
traitement/SNTPTime.cpp:
Copyright (c) 2015 Peter Dobler. All rights reserved.
